Wierzbowsky/Yamaha_RAM/Pics/assembled.jpg

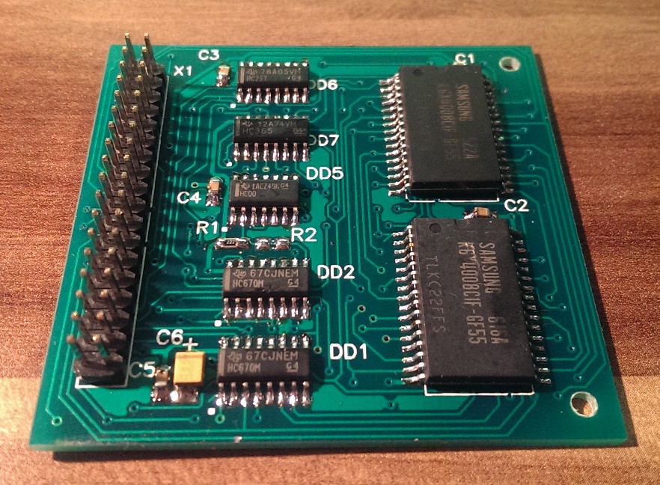
Pics/assembled.jpg
