Wierzbowsky/Yamaha_RAM/Schematics/schematics.jpg

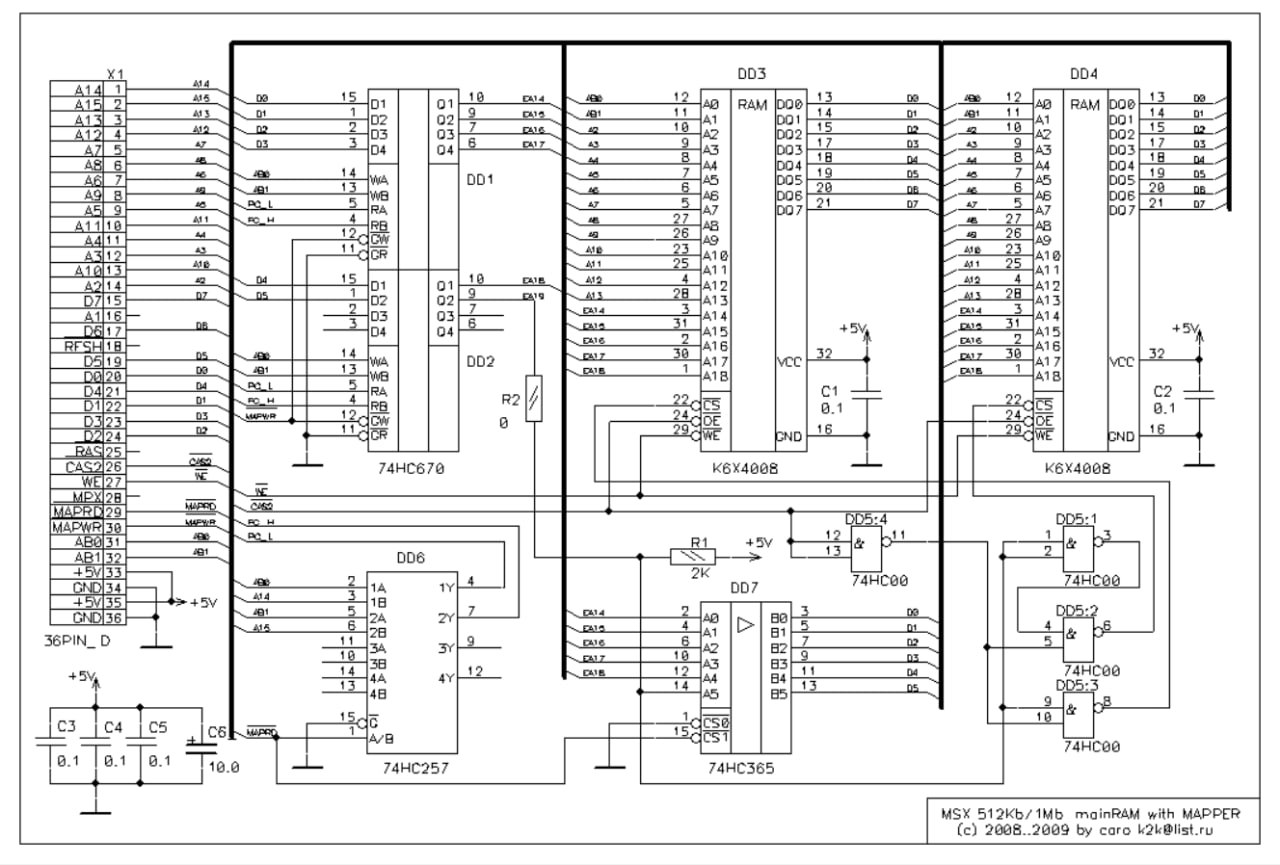
Schematics/schematics.jpg
