Wierzbowsky/Yamaha_RAM/Schematics/schematics.pdf

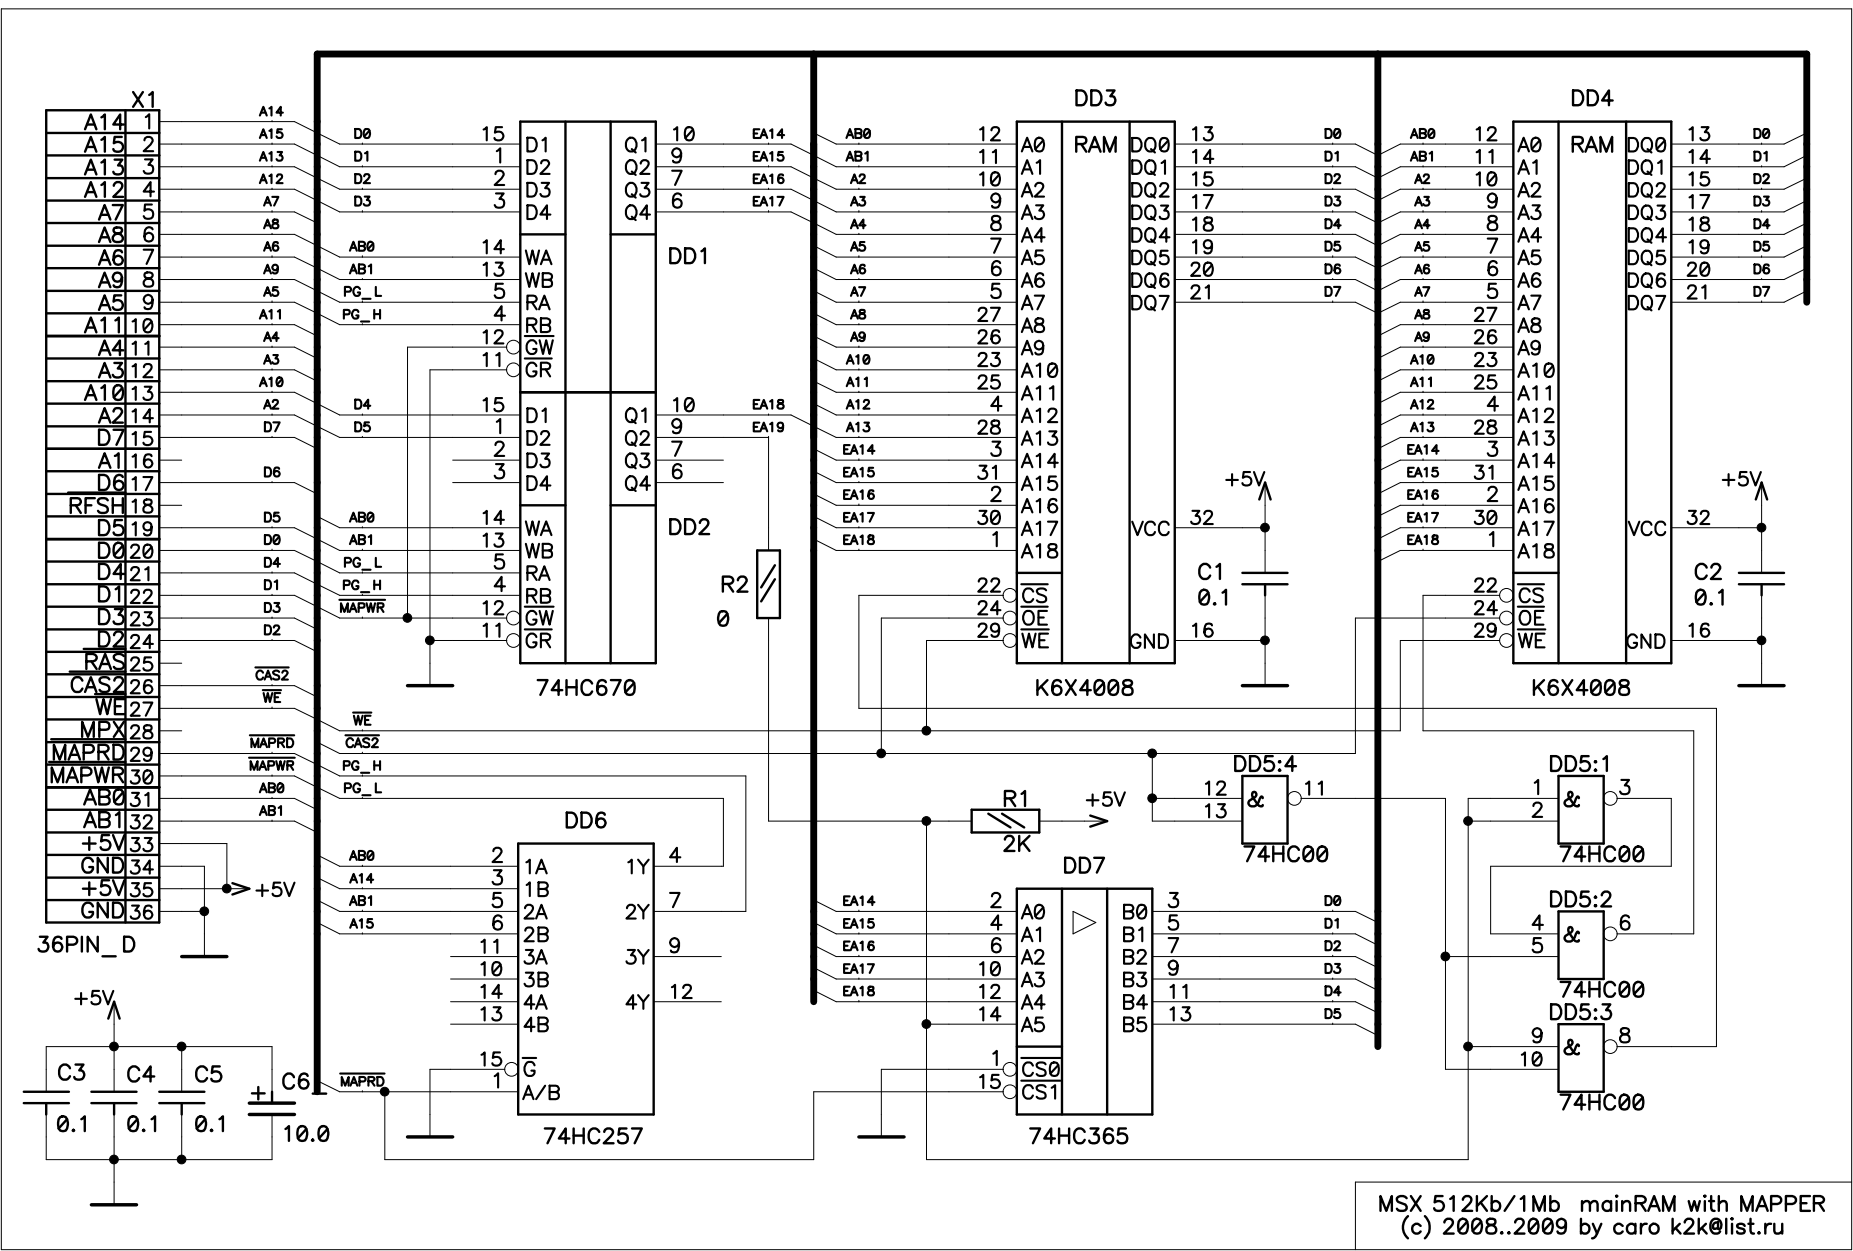
[picture p3: page 1]
