Wierzbowsky/Yamaha_RAM/(list of files, drawings)

Other design files:
Board/RAM_Board.pcb
