Wierzbowsky/Yamaha_RAM/(commit log)

2018-04-29 Initial release
    Initial release for Yamaha RAM board
    [RAM_Board.pcb]
2019-05-22 Updated readme.txt
    Added technical details for board configuration.
2026-06-15 Updated 16.06.2026
    Uploaded corrected schematics and added a partslist file.
